YusufGuldadov/Auto-Caddy/Object_detecting_system/globals.h

#ifndef GLOBALS_H
#define GLOBALS_H

extern int front;
extern int front_left;
extern int front_right;
extern int left;
extern int right;
extern int front_left_at_angle;
extern int front_rigth_at_angle;

#endif
