YusufGuldadov/Auto-Caddy/(commit log)

2025-01-27 Added starter code for motor control
2025-01-31 Added some testing code for motors
2025-02-11 Added stopping mechanism for when user is too close or when distance readings are not read fast enough
    [Bilateration.ino, User_Tracking.ino, motor_test.ino]
2025-02-12 Final code for Prototype demo. This code is working for obstacle dection system, it has been tested. Next step is system integration
2025-02-12 Changed the speed of the motor when the caddy is turning
2025-02-20 This another update to obstacle detection system, three more sensors have been added. Tested under ideal environment
2025-02-21 Modified initialization code to send and receive properly with UWB sensors
2025-02-23 This only for 5 sensors code.
2025-02-24 Changed the motor code to scale to the correct max value (255) based on a speed of 0-6 km/hr
    [User_Tracking.ino, motor_test.ino]
2025-03-03 Modified user tracking to have start up speed and more filtered angles
2025-03-05 Made some modifications to the motor driving code
2025-03-08 Changed right motor GPIO pin to 7
2025-03-08 Splited each sensor to one function
2025-03-11 figured out the issue with side sensors
    [sketch_dec15a.ino]
2025-03-21 for integration part, some trouble shooting has been done as there were error after reconnections
    [sketch_dec15a.ino]
2025-03-22 Added code to help motors start moving
